aamna-builds/5bar-chess-robot/docs/design_notes.md

# Design Notes

Motor spacing (d) = 360 mm  
Primary link (L1) = 220 mm  
Secondary link (L2) = 220 mm  

Board size = 320 mm x 320 mm  

Objective: Build a planar 5-bar parallel manipulator for automated chess movement.
