aamna-builds/5bar-chess-robot/code/src/bar.cpp

#include <raylib.h>
#include <iostream>
#include <vector>
#include "bar.h"
#include "chess.h"
#include "ui.h"
#include "state.h"
#include "serialib.h"

extern serialib arduino;
ManualControl manualControl;

const float EP = 1e-6f;

float L1 = 250;
float L2 = 290;
float L3 = L2;
float L4 = L1;
float L5 = 165;

float R1 = L1 + L2;
float R2 = L3 + L4;

// Vector2 A = {(WIDTH - L5) / 2.0f, HEIGHT / 2.0f - L1 / 2.0f};
// Vector2 B = {A.x, A.y + L1};

// Vector2 E = {A.x + L5, A.y};
// Vector2 D = {A.x + L5, A.y + L4};

// Vector2 C = {
//     A.x + L5 / 2.0f,
//     A.y + L1 + sqrt(L2 * L2 - (L5 * L5) / 4.0f)
// };

Vector2 A = {(WIDTH - L5) / 2.0f, HEIGHT / 8.0f};
Vector2 B = {A.x, A.y + L1};
Vector2 C = {A.x + L5 / 2.0f, A.y + L4 + sqrt(L2 * L2 - L5 * L5 / 4.0f)};
Vector2 D = {A.x + L5, A.y + L4};
Vector2 E = {A.x + L5, A.y};

// Vector2 A = {(WIDTH - L5) / 2.0f, HEIGHT / 2.0f};
// Vector2 B = {A.x, A.y + L1};
// Vector2 C = {A.x + L5 / 2.0f, A.y};
// Vector2 D = {A.x + L5, A.y + L4};
// Vector2 E = {A.x + L5, A.y};

std::vector<Vector2*> point = {&A, &B, &C, &D, &E};

bool dragging = false;

auto Dist = [](Vector2 a, Vector2 b)
{
    float dx = a.x - b.x;
    float dy = a.y - b.y;
    return sqrt(dx * dx + dy * dy);
};

// void ModelIK(Vector2 mPos)
// {    
//     float rx, ry, d, a, b, t, cd;
//     static bool flip = false;
//     const float accuracyEpsilon = 5.0f;

//     float distToLine = mPos.y - A.y;

//     if (fabs(distToLine) > accuracyEpsilon) {
//         flip = (distToLine > 0);
//     }
//     flip = 0;

//     rx = mPos.x - A.x;
//     ry = mPos.y - A.y;
//     d = sqrt(rx * rx + ry * ry);
//     if (d < EP) return;
    
//     a = atan2(ry, rx);
//     cd = std::clamp(d, fabs(L1 - L2), L1 + L2);
//     b = acos(std::clamp((L1 * L1 + cd * cd - L2 * L2) / (2.0f * L1 * cd), -1.0f, 1.0f));

//     t = flip ? (a + b) : (a - b);
//     B.x = A.x + L1 * cos(t);
//     B.y = A.y + L1 * sin(t);
    
//     rx = mPos.x - E.x;
//     ry = mPos.y - E.y;  
//     d = sqrt(rx * rx + ry * ry);
//     if (d < EP) return;
    
//     a = atan2(ry, rx);
//     cd = std::clamp(d, fabs(L3 - L4), L3 + L4);
//     b = acos(std::clamp((L4 * L4 + cd * cd - L3 * L3) / (2.0f * L4 * cd), -1.0f, 1.0f));
    
//     t = flip ? (a - b) : (a + b);
//     D.x = E.x + L4 * cos(t);
//     D.y = E.y + L4 * sin(t);

//     C = mPos;
// }

Vector2 GetBaseAngles() 
{
    float angleA = atan2(B.y - A.y, B.x - A.x) * RAD2DEG;
    float angleE = atan2(D.y - E.y, D.x - E.x) * RAD2DEG;
    
    return { angleA, angleE };
}

void SyncHardware() {
    if (arduino.isDeviceOpen()) {
        Vector2 angles = GetBaseAngles();
        char buffer[128];
        
        // 1. Send to Arduino
        sprintf(buffer, "%.2f,%.2f\n", angles.x, angles.y);
        arduino.writeString(buffer);

        // 2. Read back from Arduino
        // We give it a small timeout (e.g., 5ms) to wait for the response
        char feedback[128];
        int n = arduino.readString(feedback, '\n', 128, 5);
        
        if (n > 0) {
            printf("HARDWARE FEEDBACK: %s", feedback);
        }
    }
}

void ModelIK(Vector2 mPos)
{    
    float rx, ry, d, a, b, t, cd;
 
    // point B
    rx = mPos.x - A.x;
    ry = mPos.y - A.y;

    d = sqrt(rx * rx + ry * ry);
    if (d < EP) return;
    
    a = atan2(ry, rx);

    cd = std::clamp(d, fabs(L1 - L2), L1 + L2);

    C.x = A.x + cd * cos(a);
    C.y = A.y + cd * sin(a);
    
    b = (L1 * L1 + cd * cd - L2 * L2) / (2.0f * L1 * cd);
    b = acos(std::clamp(b, -1.0f, 1.0f));

    t = a + b;

    B.x = A.x + L1 * cos(t);
    B.y = A.y + L1 * sin(t);
    
    // point D
    rx = C.x - E.x;
    ry = C.y - E.y;  

    d = sqrt(rx * rx + ry * ry);
    if (d < EP) return;
    
    a = atan2(ry, rx);

    cd = std::clamp(d, fabs(L3 - L4), L3 + L4);

    C.x = E.x + cd * cos(a);
    C.y = E.y + cd * sin(a);
    
    b = (L4 * L4 + d * d - L3 * L3) / (2.0f * L4 * d);
    b = acos(std::clamp(b, -1.0f, 1.0f));
    
    t = a - b;

    D.x = E.x + L4 * cos(t);
    D.y = E.y + L4 * sin(t);
}

void ModelK()
{
    static int step = 0;

    if (simState.moveQueue.empty()) return;
    std::vector<Vector2> points = simState.moveQueue.front();

    if (step < points.size())
    {
        simState.stage = Stage::Tracing;

        Vector2 p = points[step];
        ModelIK({p.x, p.y});
        
        step++;
    }
    else
    {
        step = 0;
        
        Vector2 lastPos = simState.moveQueue.front().back();
        simState.accPos.x = (int)lastPos.x;
        simState.accPos.y = (int)lastPos.y;
        simState.stage = Stage::TraceFinished;
        simState.moveQueue.erase(simState.moveQueue.begin());
        simState.latchQueue.erase(simState.latchQueue.begin());
    }
}

void UpdateBar(void)
{
    if (!manualControl.active)
    {
        manualControl.pos = {C.x, C.y};
    }

    float speed = 75.0f * GetFrameTime();

    if (IsKeyPressed(KEY_TAB))
    {
        manualControl.active = !manualControl.active;
    }

    if (manualControl.active)
    {
        if (IsKeyDown(KEY_W)) manualControl.pos.y += speed;
        if (IsKeyDown(KEY_S)) manualControl.pos.y -= speed;
        if (IsKeyDown(KEY_A)) manualControl.pos.x -= speed;
        if (IsKeyDown(KEY_D)) manualControl.pos.x += speed;

        ModelIK(manualControl.pos);
        SyncHardware();

        return;
    }

    if (IsMouseButtonPressed(MOUSE_BUTTON_LEFT) &&
        CheckCollisionPointCircle(GetMousePosition(), {C.x, HEIGHT - C.y}, 10)) dragging = true;
    
    if (IsMouseButtonReleased(MOUSE_BUTTON_LEFT)) dragging = false;

    if (dragging && simState.stage != Stage::Tracing)
    {
        Vector2 mPos = GetMousePosition();
        mPos.y = HEIGHT - mPos.y;

        ModelIK(mPos);
        SyncHardware();
    }

    static float cTick = 0.0f;
    static float tick = 0.05f;

    cTick += GetFrameTime();
    if (cTick >= tick)
    {
        cTick = 0.0f;

        ModelK();
        SyncHardware();
    }
}

void DrawRange(void)
{
    // testing
    float l1d = Dist(*point[0], *point[1]);
    float l2d = Dist(*point[1], *point[2]);
    float l3d = Dist(*point[2], *point[3]);
    float l4d = Dist(*point[3], *point[4]);
    float l5d = Dist(*point[4], *point[0]);

    DrawText(TextFormat("l1: %.2f", l1d), 20, 20, 20, BLACK);
    DrawText(TextFormat("l2: %.2f", l2d), 20, 45, 20, BLACK);
    DrawText(TextFormat("l3: %.2f", l3d), 20, 70, 20, BLACK);
    DrawText(TextFormat("l4: %.2f", l4d), 20, 95, 20, BLACK);
    DrawText(TextFormat("l5: %.2f", l5d), 20, 120, 20, BLACK);

    auto Valid = [&](Vector2 p)
    {
        float dxA = p.x - A.x;
        float dyA = p.y - A.y;

        float dxE = p.x - E.x;
        float dyE = p.y - E.y;

        float dA = dxA * dxA + dyA * dyA;
        float dE = dxE * dxE + dyE * dyE;

        return (dA <= R1 * R1 && dE <= R2 * R2);
    };
    float yc = A.y;
    float r = (R1 > R2) ? R1 : R2;

    const int step = 7;
    for (int x = 0; x < WIDTH; x += step)
    {
        for (int y = yc - r; y <= yc + r; y += step)
        {
            if (y < 0 || y >= HEIGHT) continue;

            Vector2 p = {(float)x, (float)y};
            if (Valid(p)) DrawPixel(x, HEIGHT - y, GRAY);
        }
    }
}

void DrawBar(void)
{
    static const Color ARM_PRIMARY = { 45, 45, 55, 255 }; 
    static const Color JOINT_ACCENT = { 70, 70, 85, 255 };
    static const Color STATUS_ACTIVE = { 34, 197, 94, 255 };
    static const Color STATUS_BUSY = { 249, 115, 22, 255 };

    for (int i = 0; i < 4; ++i)
    {
        Vector2 p1 = { point[i]->x, HEIGHT - point[i]->y };
        Vector2 p2 = { point[i + 1]->x, HEIGHT - point[i + 1]->y };
        
        DrawLineEx(p1, p2, 5.0f, { 0, 0, 0, 30 }); 
        DrawLineEx(p1, p2, 3.5f, ARM_PRIMARY);
    }

    for (int i = 0; i < 5; ++i)
    {
        Color statusColor = JOINT_ACCENT;

        if (i == 2)
        {
            if (!simState.latchQueue.empty() && simState.latchQueue.front()) statusColor = STATUS_BUSY;
            else statusColor = STATUS_ACTIVE;
        }

        Vector2 p = { point[i]->x, HEIGHT - point[i]->y };
        
        DrawCircleV(p, 8.0f, WHITE);
        DrawCircleLinesV(p, 8.0f, ARM_PRIMARY);
        DrawCircleV(p, 4.0f, statusColor);
    }

    Vector2 angles = GetBaseAngles();
    const float arcRadius = 15.0f;
    const Color TEXT_COLOR = { 60, 60, 70, 255 };

    Vector2 screenA = { A.x, HEIGHT - A.y };
    for(int t = 0; t < 5; t++) 
        DrawCircleSectorLines(screenA, arcRadius - (t * 0.5f), 0, -angles.x, 16, ARM_PRIMARY);
    DrawTextEx(font, TextFormat("%.1f deg", angles.x), { screenA.x - 25, screenA.y + 20 }, 13, 1, TEXT_COLOR);

    Vector2 screenE = { E.x, HEIGHT - E.y };
    for(int t = 0; t < 5; t++) 
        DrawCircleSectorLines(screenE, arcRadius - (t * 0.5f), 0, -angles.y, 16, ARM_PRIMARY);
    DrawTextEx(font, TextFormat("%.1f deg", angles.y), { screenE.x - 25, screenE.y + 20 }, 13, 1, TEXT_COLOR);

    // DrawRange();
}
