aamna-builds/5bar-chess-robot/(commit log)

2026-02-16 Created CAD folder
2026-02-16 Created Arduino folder
2026-02-16 Added 5-bar kinematics documentation
2026-03-15 ui: better visuals, added motor angles
2026-11-11 created: arduino code
2026-11-11 Add MATLAB kinematics and design toolbox
    IK/FK/Jacobian, singularity margins, workspace analysis (v1 vs v2),
    layout optimisation, torque and step-rate analysis, motion planning
    demo and the square lookup table. Runs in MATLAB and GNU Octave.
2026-11-11 Add host software: chess rules, path planner, simulator
    Own rules engine verified with perft, lane-based collision-free path
    planning with graveyard parking, castling, en passant and promotion,
    serial driver and an offline animated simulator.
2026-11-11 Add Arduino firmware
    On-board inverse kinematics, whole-line safety check before each move,
    trapezoidal speed profile and coordinated stepping without external
    stepper libraries. PC unit tests cross-check against MATLAB.
2026-11-11 Add live browser simulator with GitHub Pages deployment
    Play chess against the robot, drive the arm over a live singularity
    map, and reshape the linkage. Core logic is a port of the host package
    and is tested in CI (perft, MATLAB cross-check, planner).
2026-11-11 Shrink README media from 17 MB to about 5 MB
    Re-encode the GIFs with smaller palettes, lower frame rates and
    lossy compression, switch the simulator screenshot to JPEG, and
    lazy-load everything below the first demo row.
